ZELDA-LINK-F/ESP8266_OneNet/README.md

# 工程实训

## 项目简介

本项目为物联网（IoT）综合项目实战课程配套工程，涵盖从 PCB 硬件设计、嵌入式 MCU 固件开发、IoT 通信协议、云平台对接，到上位机可视化界面的完整开发链路。

## 实训周期

- **开始日期**：2026 年 7 月 10 日
- **结束日期**：2026 年 7 月 20 日
- **总时长**：11 天（含 1 天休息日：7 月 18 日）
- **实训形式**：项目驱动，边学边做

## 技术栈概览

| 层级 | 技术内容 |
|---|---|
| 硬件层 | Altium Designer 20.2.6（原理图 + PCB Layout） |
| 嵌入式层 | MCU 外设（GPIO / 中断 / I2C）、AT 指令框架、传感器驱动 |
| 通信层 | MQTT 协议、阿里云物联网平台 |
| 应用层 | PyQt5 上位机、数据可视化 |
| 辅助工具 | AI 编程助手 |

## 日程安排

| 日期 | 星期 | 核心模块 | 课程内容 |
|---|---|---|---|
| 7.10 | 周五 | PCB 设计与评审 | 上午：底图设计；下午：PCB Layout |
| 7.11 | 周六 | PCB Layout | 上午：PCB Layout；下午：PCB Layout 评审 |
| 7.12 | 周日 | MCU 外设与传感器驱动 | 上午：开发环境与 GPIO/中断；下午：I2C 总线与传感器 |
| 7.13 | 周一 | 通信模块驱动与系统整合 | 上午：AT 指令与数据框架；下午：AT 指令与数据框架 |
| 7.14 | 周二 | MQTT 协议与云平台接入 | 上午：MQTT 协议与阿里云配置；下午：嵌入式 MQTT 客户端实现 |
| 7.15 | 周三 | 数据上传与云平台交互 | 上午：物模型数据上报与属性设置；下午：物模型数据上报与属性设置 |
| 7.16 | 周四 | AI 辅助与上位机基础 | 上午：AI 编程工具赋能；下午：PyQt5 基础与 AI 实践 |
| 7.17 | 周五 | 数据可视化与云对接 | 上午：功能实现与美化；下午：功能实现与美化 |
| 7.18 | 周六 | —— | 休息 |
| 7.19 | 周日 | 全链路联调与优化 | 上午：集成测试与故障排除；下午：集成测试与故障排除 |
| 7.20 | 周一 | 项目验收与路演 | 上午：项目完善与文档整理；下午：项目成果路演 |

> 详细每日任务清单见 `01_项目需求文档/项目日程与每日计划.md`。

## 项目目录结构

```
工程实训/
├── 01_项目需求文档/         # 需求规格说明书、模块索引、每日计划
├── 02_原理图/               # Altium Designer 原理图（.SchDoc）
├── 03_PCB源文件/            # Altium Designer PCB（.PcbDoc）
├── 04_Gerber文件/           # 生产用 Gerber + 钻孔文件
├── 05_BOM表/                # 物料清单
├── 06_程序源码/
│   ├── MCU固件/             # 单片机代码（AT_Framework / MQTT_Client / Sensor_Driver）
│   └── PyQt5上位机/         # 上位机代码
├── 07_云平台配置/           # 阿里云物模型、Topic、证书
├── 08_测试报告/             # 功能测试、集成测试记录
├── 09_项目文档/             # 设计说明、用户手册、答辩 PPT
├── 10_参考资料/             # 芯片手册、参考资料
├── 11_AI工具/               # 提示词模板、AI 使用记录
└── README.md                # 本文件
```

## 项目状态

> 状态图例：`[ ]` 待开始  `[~]` 进行中  `[x]` 已完成

| 阶段 | 状态 | 负责人 | 起始日 | 完成日 |
|---|---|---|---|---|
| 需求分析 | [x] 已完成 | | 7.10 | 7.10 |
| 原理图设计 | [~] 进行中 | | 7.10 | |
| PCB Layout | [ ] 待开始 | | 7.10 | |
| MCU 固件 | [ ] 待开始 | | 7.12 | |
| 通信模块 | [ ] 待开始 | | 7.13 | |
| 云平台对接 | [ ] 待开始 | | 7.14 | |
| 上位机 | [ ] 待开始 | | 7.16 | |
| 集成测试 | [ ] 待开始 | | 7.19 | |
| 验收路演 | [ ] 待开始 | | 7.20 | |

最近更新：2026-07-10（Day 1 准备阶段，需求文档已完成，原理图与 PCB 正式开始）。

## 备注

- 原理图和 PCB 文件需使用 **Altium Designer 20.2.6** 打开
- 所有源文件命名建议使用英文或拼音，避免中文路径导致兼容性问题
- Gerber 文件输出前务必自检并完成 DRC
- 文档保存编码：UTF-8（无 BOM），避免中文丢失
