ZELDA-LINK-F/ESP8266_OneNet/(list of files, drawings)

Other design files:
STM_249044368/PCB1.PcbDoc
STM_249044368/PCB1.PcbLib
STM_249044368/Sheet1.SchDoc
STM_249044368/STM_249044368.PrjPcb
