ZELDA-LINK-F/ESP8266_OneNet/(commit log)

2026-07-16 Initial commit: STM32 IoT 工程实训（精简版）
    [PCB1.PcbDoc, PCB1.PcbLib, STM_249044368.PrjPcb, Sheet1.SchDoc]
2026-07-16 chore: 完善.gitignore，防止大文件误传
2026-07-17 refactor: main.c 模块化拆分 + 软件I2C AHT20驱动 + OneNET Web仪表盘
    - 将 main.c 拆分为 app_tasks 模块，添加 app_tasks.h/c
    - 新增 aht20_soft.c/h 软件I2C驱动，解决PB6/PB7引脚冲突
    - 新增 onenet_web/ Node.js 仪表盘服务器
    - 更新 .gitignore 忽略 .opencode/ 和 node_modules/
